jrphill5/LaserEtcher/BillOfMaterials.xlsx

Description | Vendor | Part Number | Quantity |  |  | Price |  |  |  | Link
 |  |  | Pieces | Need | Lot | Lot | Shipping | Piece | Extended
M5-0.8x16 Socket Head Screw, Zinc-Plated Steel | McMaster-Carr | 90128A244 | 100 | 22 | 0.22 | $9.39 | $0.00 | $0.09 | $2.07 | Link (https://www.mcmaster.com/)
M5-0.8x25 Socket Head Screw, Zinc-Plated Steel | McMaster-Carr | 90128A249 | 100 | 16 | 0.16 | $10.81 | $0.00 | $0.11 | $1.73 | Link (https://www.mcmaster.com/)
M5-0.8x16 Button Head Screw, Zinc-Plated Steel | McMaster-Carr | 91306A667 | 100 | 14 | 0.14 | $12.39 | $0.00 | $0.12 | $1.73 | Link (https://www.mcmaster.com/)
M5 Washer, Zinc-Plated Steel | McMaster-Carr | 91166A240 | 200 | 44 | 0.22 | $2.19 | $0.00 | $0.01 | $0.48 | Link (https://www.mcmaster.com/)
M5 Nut, Zinc-Plated Steel | McMaster-Carr | 90591A146 | 100 | 16 | 0.16 | $2.08 | $0.00 | $0.02 | $0.33 | Link (https://www.mcmaster.com/)
M3-0.5x10 Socket Head Screw, Zn-Al-Plated Steel | McMaster-Carr | 91274A105 | 50 | 8 | 0.16 | $5.28 | $0.00 | $0.11 | $0.84 | Link (https://www.mcmaster.com/)
M3 Washer, Zinc-Plated Steel | McMaster-Carr | 91166A210 | 100 | 8 | 0.08 | $1.61 | $0.00 | $0.02 | $0.13 | Link (https://www.mcmaster.com/)
Rod, Threaded, Acme, 3/8"-12x3ft | McMaster-Carr | 98935A817 | 1 | 2 | 2 | $4.30 | $0.00 | $4.30 | $8.60 | Link (https://www.mcmaster.com/)
Nut, Hex, Acme, 3/8"-12 | McMaster-Carr | 94815A106 | 1 | 2 | 2 | $2.35 | $0.00 | $2.35 | $4.70 | Link (https://www.mcmaster.com/)
Coupling Hub, 3/16" (needs 5mm drill) | McMaster-Carr | 6408K9 | 1 | 2 | 2 | $4.14 | $0.00 | $4.14 | $8.28 | Link (https://www.mcmaster.com/)
Coupling Hub, 3/8" | McMaster-Carr | 6408K9 | 1 | 2 | 2 | $4.14 | $0.00 | $4.14 | $8.28 | Link (https://www.mcmaster.com/)
Spider, Buna-N | McMaster-Carr | 6408K61 | 1 | 2 | 2 | $1.89 | $0.00 | $1.89 | $3.78 | Link (https://www.mcmaster.com/)
Grommet, Rubber, 5/16" ID | Lowes | 423655 | 30 | 8 | 0.2666666667 | $12.90 | $0.00 | $0.43 | $3.44 | Link (https://www.lowes.com/pd/The-Hillman-Group-30-Pack-5-16-in-Inside-Diameter-Rubber-Grommets/4437271)
Nut, Square, M5-0.8 | Misumi | HNKK5-5 | 100 | 14 | 0.14 | $19.32 | $0.00 | $0.19 | $2.70 | Link (https://us.misumi-ec.com/vona2/detail/110302246940/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)
Extrusion, Aluminum, 20x75mm | Misumi | HFS5-2020-75 | 1 | 4 | 4 | $3.03 | $0.00 | $3.03 | $12.12 | Link (https://us.misumi-ec.com/vona2/detail/110302683830/?HissuCode=HFS5-2020-%5B50-4000%2F0.5%5D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)
Extrusion, Aluminum, 20x125mm | Misumi | HFS5-2020-125 | 1 | 4 | 4 | $3.03 | $0.00 | $3.03 | $12.12 | Link (https://us.misumi-ec.com/vona2/detail/110302683830/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)
Extrusion, Aluminum, 20x500mm | Misumi | HFS5-2020-500 | 1 | 4 | 4 | $2.85 | $0.00 | $2.85 | $11.40 | Link (https://us.misumi-ec.com/vona2/detail/110302683830/?HissuCode=HFS5-2020-%5B50-4000%2F0.5%5D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)
Extrusion, Aluminum, 20x600mm | Misumi | HFS5-2020-600 | 1 | 2 | 2 | $3.42 | $0.00 | $3.42 | $6.84 | Link
Extrusion, Aluminum, 20x500mm | Misumi | HFS5-2020-500 | 1 | 2 | 2 | $2.85 | $0.00 | $2.85 | $5.70 | Link (https://us.misumi-ec.com/vona2/detail/110302683830/?HissuCode=HFS5-2020-%5B50-4000%2F0.5%5D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)
Bearing, Linear, 12mm | Amazon | LM12UU | 4 | 6 | 1.5 | $11.74 | $0.00 | $2.94 | $17.61 | Link (https://www.amazon.com/dp/B00N41DRAW/)
Bearing, Rotary, 3/8" | Amazon | R6-2RS | 10 | 4 | 0.4 | $12.75 | $0.00 | $1.27 | $5.10 | Link (https://www.amazon.com/gp/product/B01CUNOWWG/)
Rod, Smooth, 12mm, 500mm | Amazon | QS12MM500 | 1 | 4 | 4 | $16.73 | $0.00 | $16.73 | $66.92 | Link (https://www.amazon.com/gp/product/B00TSGLXFS/)
Support, Smooth Rod | Amazon | SHF12 | 4 | 8 | 2 | $10.99 | $0.00 | $2.75 | $21.98 | Link (https://www.amazon.com/gp/product/B00C4PBMMY/)
Arduino, Uno R3 | Amazon |  | 1 | 1 | 1 | $24.99 | $0.00 |  | $24.99 | Link (https://www.amazon.com/Arduino-Uno-R3-Microcontroller-A000066/dp/B008GRTSV6/)
Button, Control, Green | Amazon |  | 5 | 1 | 0.2 | $9.26 | $0.00 | $1.85 | $1.85 | Link (https://www.amazon.com/gp/product/B009IQJY5Y/)
Button, Control, Blue | Amazon |  | 5 | 1 | 0.2 | $9.60 | $0.00 | $1.92 | $1.92 | Link (https://www.amazon.com/gp/product/B0097B7LYG/)
Button, Control, Yellow | Amazon |  | 5 | 1 | 0.2 | $9.23 | $0.00 | $1.85 | $1.85 | Link (https://www.amazon.com/gp/product/B009IQK084/)
Button, Emergency Stop | Amazon |  | 1 | 1 | 1 | $4.99 | $0.00 | $4.99 | $4.99 | Link (https://www.amazon.com/gp/product/B0094GM004/)
Driver, Stepper Motor | Amazon | TB6560 | 1 | 2 | 2 | $8.39 | $0.00 | $8.39 | $16.78 | Link (https://www.amazon.com/gp/product/B00LPK02SY/)
Power Supply, 12VDC, 180W | Amazon |  | 1 | 1 | 1 | $19.98 | $0.00 | $19.98 | $19.98 | Link (https://www.amazon.com/dp/B00MAC9MO6/)
Socket, AC | Amazon |  | 1 | 1 | 1 | $5.81 | $0.00 | $5.81 | $5.81 | Link (https://www.amazon.com/dp/B00ME5YAPK/)
Stepper Motor, NEMA17 | Amazon | 17HS16-2004S | 1 | 2 | 2 | $12.99 | $0.00 | $12.99 | $25.98 | Link (https://www.amazon.com/gp/product/B00PNEQI7W/)
Switch, Limit, SPST | Amazon |  | 10 | 4 | 0.4 | $6.19 | $0.00 | $0.62 | $2.48 | Link (https://www.amazon.com/gp/product/B00E0JOTV8/)
Switch, Power | Amazon |  | 1 | 1 | 1 | $7.17 | $0.00 | $7.17 | $7.17 | Link (https://www.amazon.com/dp/B00VG9GGUM/)
Heatsink, 12mm | Amazon |  | 1 | 1 | 1 | $3.50 | $3.57 | $7.07 | $7.07 | Link (https://www.amazon.com/gp/product/B00DYVBB3W/)
Laser Diode, 6W, 450nm, w/Lens | Amazon | NUBM44 | 1 | 1 | 1 | $160.00 | $0.00 | $160.00 | $160.00 | Link (https://www.amazon.com/dp/B014NN3AYW/)
Driver, Laser Diode, 4.5A, X-Drive | Amazon |  | 1 | 1 | 1 | $30.00 | $0.00 | $30.00 | $30.00 | Link (https://www.amazon.com/dp/B01MF67NWC/)
Adhesive, Thermal, Arctic Silver, in Grams | Amazon | ASTA-7G | 7 | 1 | 0.1428571429 | $11.59 | $0.00 | $1.66 | $1.66 | Link (https://www.amazon.com/dp/B0087X7262/)
Goggles, Laser Safety, 450nm
Total |  |  |  |  |  |  |  |  | $519.41
