jrphill5/LaserEtcher/OpenSCAD/01_Meshes/08_ExtrusionWireClip.stl

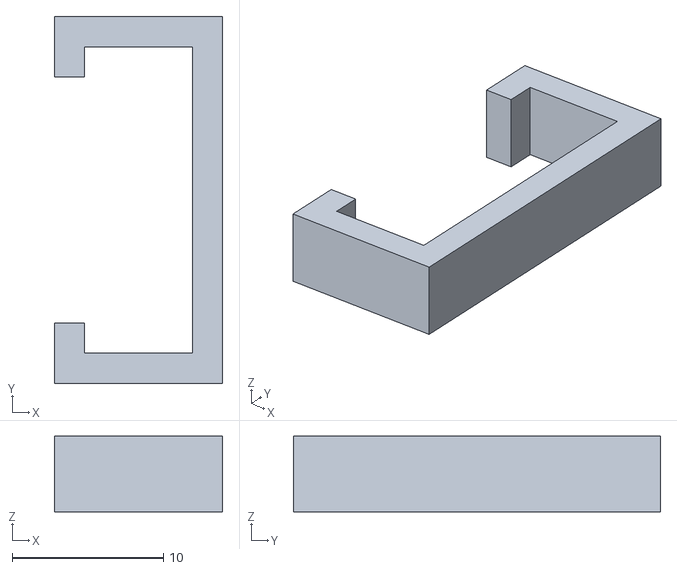
[picture p1: CAD file, 2017-05-21]
OpenSCAD/01_Meshes/08_ExtrusionWireClip.stl
11.1 x 24.2 x 5.00
