jrphill5/LaserEtcher/OpenSCAD/01_Meshes/06_YAxisBlankEndstop.stl

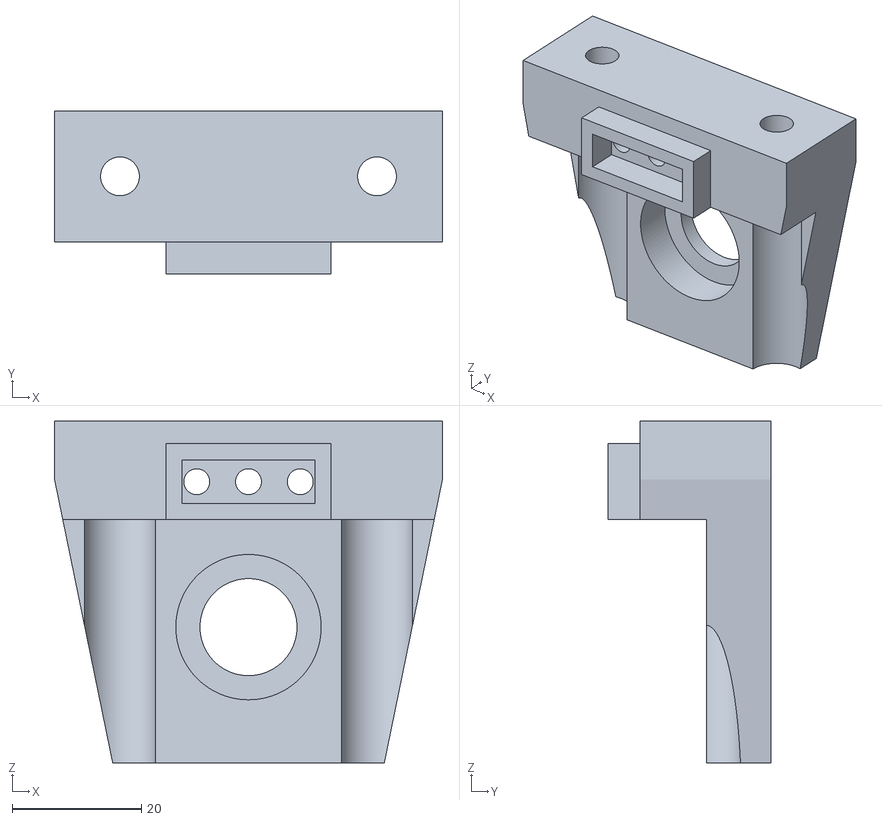
[picture p2: CAD file, 2017-05-21]
OpenSCAD/01_Meshes/06_YAxisBlankEndstop.stl
60.0 x 25.2 x 52.9
