jrphill5/LaserEtcher/OpenSCAD/01_Meshes/06_YAxisBearingBracket.stl

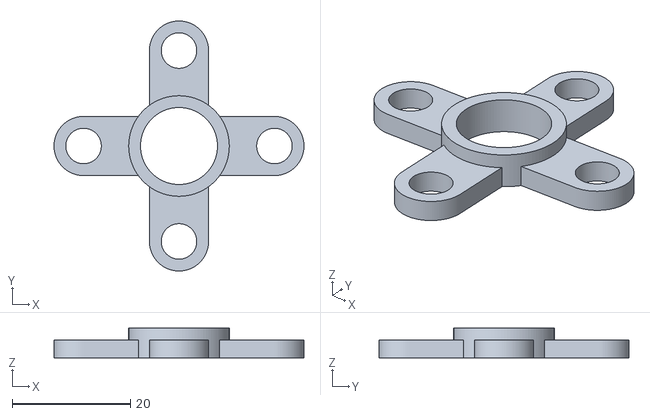
[picture p3: CAD file, 2017-05-21]
OpenSCAD/01_Meshes/06_YAxisBearingBracket.stl
42.2 x 42.2 x 5.00
