jrphill5/LaserEtcher/OpenSCAD/01_Meshes/04_ToolheadSledBumper.stl

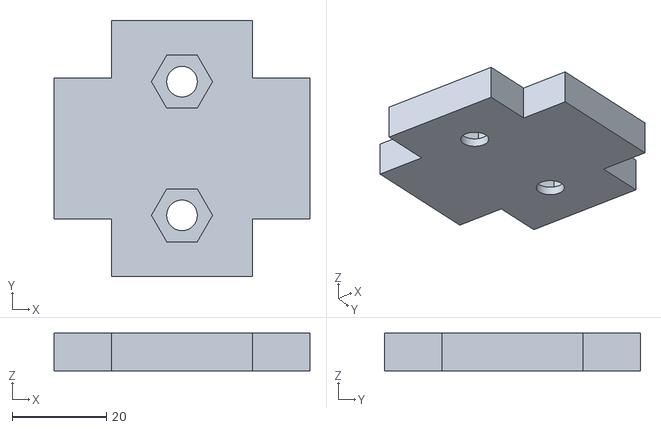
[picture p4: CAD file, 2017-01-05]
OpenSCAD/01_Meshes/04_ToolheadSledBumper.stl
54.4 x 54.4 x 8.00
