jrphill5/LaserEtcher/OpenSCAD/01_Meshes/03_ToolheadSled.stl

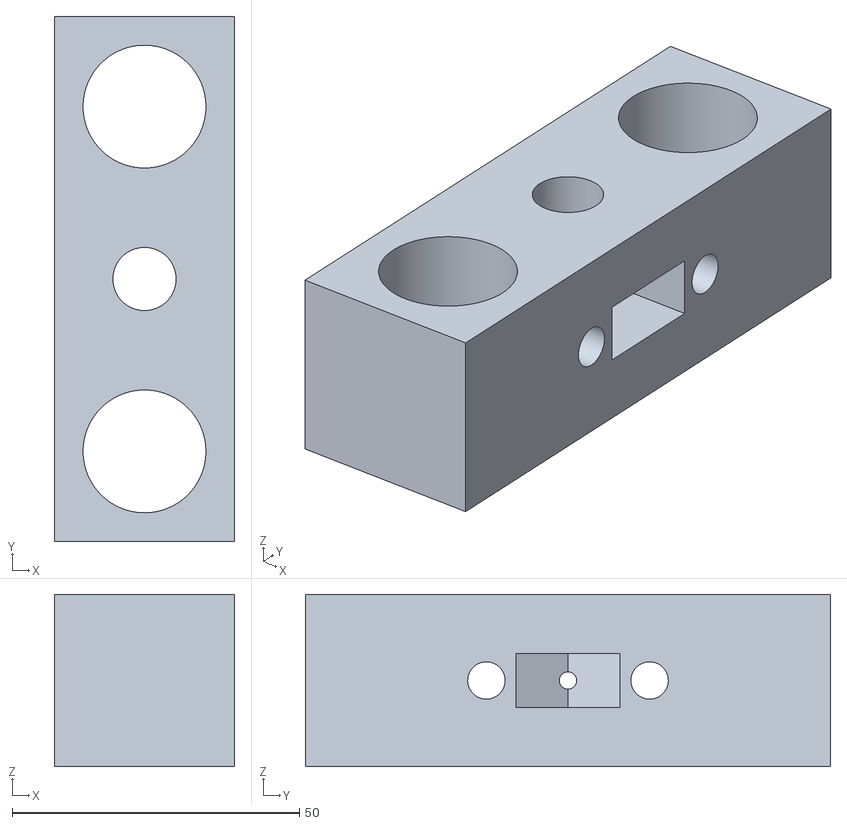
[picture p5: CAD file, 2017-01-05]
OpenSCAD/01_Meshes/03_ToolheadSled.stl
31.4 x 91.4 x 30.0
