jrphill5/LaserEtcher/OpenSCAD/01_Meshes/01_StepperMount.stl

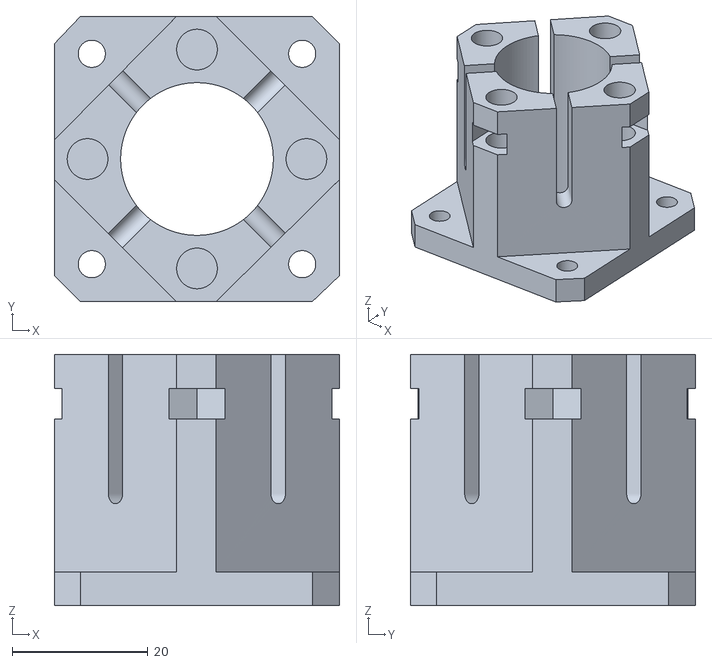
[picture p6: CAD file, 2017-01-05]
OpenSCAD/01_Meshes/01_StepperMount.stl
42.0 x 42.0 x 37.0
