jrphill5/LaserEtcher/OpenSCAD/01_Meshes/07_YAxisNutMount.stl

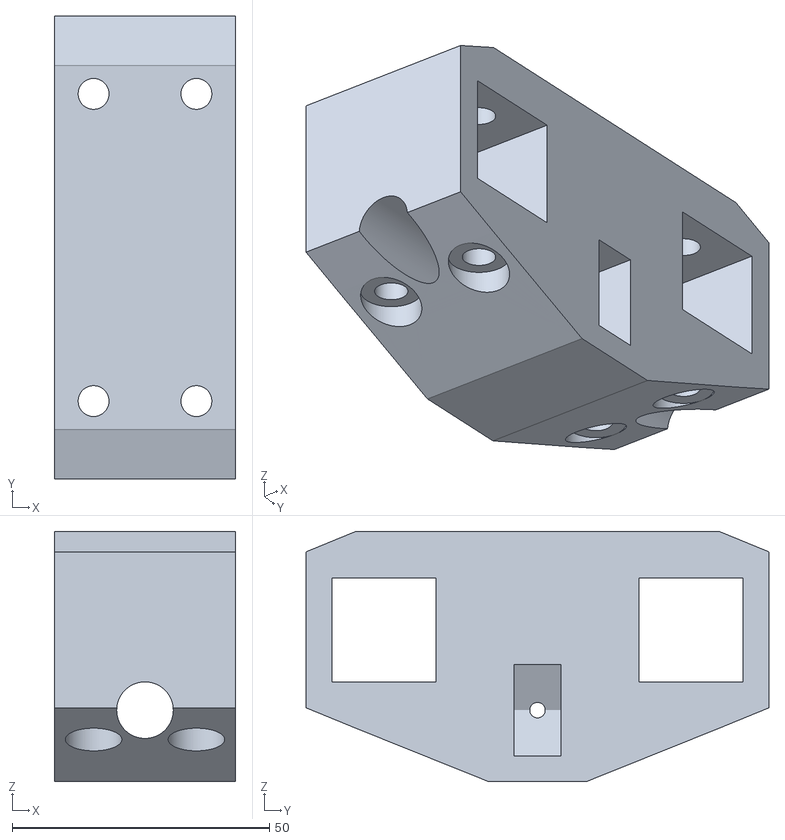
[picture p7: CAD file, 2017-01-05]
OpenSCAD/01_Meshes/07_YAxisNutMount.stl
35.2 x 90.0 x 48.6
