jrphill5/LaserEtcher/OpenSCAD/01_Meshes/05_XYAxesCoupler.stl

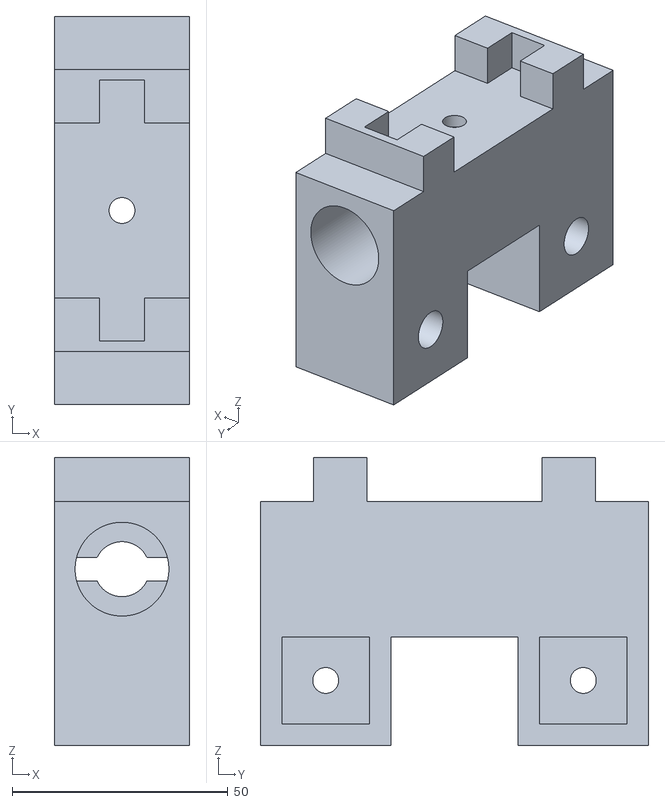
[picture p8: CAD file, 2017-01-05]
OpenSCAD/01_Meshes/05_XYAxesCoupler.stl
31.4 x 90.0 x 66.9
