jrphill5/LaserEtcher/OpenSCAD/01_Meshes/02_XAxisBlankEndstop.stl

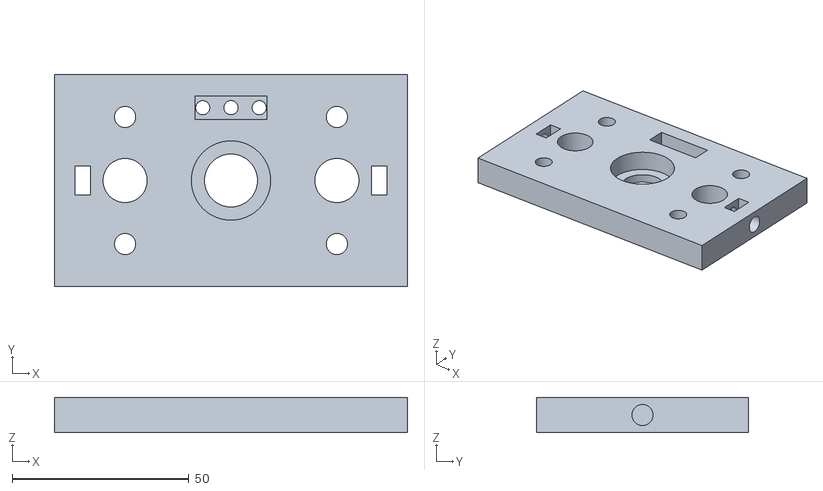
[picture p10: CAD file, 2017-01-05]
OpenSCAD/01_Meshes/02_XAxisBlankEndstop.stl
100.0 x 60.0 x 10.0
