jrphill5/LaserEtcher/OpenSCAD/00_Source/06_YAxisBearingBracket.scad

include <00_GlobalVariables.scad>

use <02_XAxisBearingBracket.scad>

module 06_YAxisBearingBracket(){
    02_XAxisBearingBracket();
}

06_YAxisBearingBracket();
