jrphill5/LaserEtcher/(list of files, cad)

Other CAD files:
OpenSCAD/01_Meshes/06_YAxisStepperEndstop.stl
OpenSCAD/01_Meshes/02_XAxisBearingBracket.stl
