jrphill5/LaserEtcher/(commit log)

2017-01-05 Initial import of files
    [00_GlobalVariables.scad, 01_StepperMount.scad, 01_StepperMount.stl, 02_XAxisBlankEndstop.scad, 02_XAxisBlankEndstop.stl, 02_XAxisStepperEndstop.scad, 02_XAxisStepperEndstop.stl, 03_ToolheadSled.scad]
2017-05-21 Added bracket to apply pressure to X axis stepper bearing.
    [02_XAxisBearingBracket.scad, 02_XAxisBearingBracket.stl]
2017-05-21 Modularized stepper bearing bracket and added one for Y axis.
    [02_XAxisBearingBracket.scad, 06_YAxisBearingBracket.scad, 06_YAxisBearingBracket.stl]
2017-05-21 Modified Y axis endstops to accept bearing brackets.
    [06_YAxisBlankEndstop.scad, 06_YAxisBlankEndstop.stl, 06_YAxisStepperEndstop.scad, 06_YAxisStepperEndstop.stl]
2017-05-21 Added clip for constraining wires inside extrusion profile.
    [08_ExtrusionWireClip.scad, 08_ExtrusionWireClip.stl]
